chouhai12138/lite_Recording_Board/DOCS/开发步骤清单_v1.1.md

# 开发步骤清单 v1.1（底板未到 → 串口优先）

> 依据：`DOCS/STM32_软件框架与实施步骤.md`（框架，S0~S11）、
> `DOCS/STM32F407_电机驱动移植方案.md`（设计细节）、
> 参考实现：`/data/lite_motor_ws/src/lite_driver`。
> 本清单只改**执行顺序**，不改已冻结的设计决策。

---

## 0. 现状盘点

### 0.1 目标（文档已定）

独立板（不接 ROS）：双 CAN、4 键、ST7789 240×240、W25Q64、24C02、硬件急停；
功能 = MIT/CSP 控制、重力补偿拖动、动作录制/回放（5 槽）、16 轴归零。
裸机 + 1 ms 协作式调度，坐标空间全部用电机 raw。

### 0.2 可直接复用的资产（来自 lite_driver）

| 资产 | 路径 | 用法 |
|---|---|---|
| 帧编解码 / 量程 / 参数 ID | `include/lite_driver/protocol.hpp` | 逐行翻成 C（`rs_protocol.c/h`） |
| 协议测试向量 | `test/test_protocol.cpp`（409 行） | 改成主机侧 C 单测，逐字节比对 |
| 归零序列 | `src/tools/set_zero.cpp` | 照抄：失能→读 raw→类型 6→回读 |
| 拖动/激活斜坡 | `lite_controller/hold_controller` | 保留 Kp=0 / Kd / τ_ff 语义 |
| 重力模型 | `lite_controller/gravity_compensator` + `config/gravity/*` | 离线生成 C 表 + 手写 FK |
| 关节方向 | `lite_calibration/config/calibration.yaml` | 只取 `direction`（±1，重力用） |
| 电机静态参数 | `lite_controller/config/gravity/joint_spec.yaml` | 生成 `robot_config.c/h` |
| 惯量参数 | `lite_controller/config/gravity/inertia_params.yaml` | 生成重力表 |

### 0.3 当前硬件实况

| 资源 | 引脚 | 状态 |
|---|---|---|
| 调试串口 USART1 | PA9 / PA10 | ✅ 已通（WCH-Link CDC → `/dev/ttyACM0`） |
| SWD | PA13 / PA14 | ✅ 已通（WCH-Link） |
| 晶振 | HSE 25 MHz | ✅ 已确认（168 MHz） |
| LED RUN / CAN / FAULT | PA15 / PD15 / PD13 | ✅ 已驱动（PD12 已改为 LCD DC） |
| 按键 UP / DOWN | PA0（高有效）/ PD14（低有效） | ✅ 已驱动（底板左右键待定） |
| LCD 1.54" ST7789 240×240 | SPI2: PB13/PB15/PB14，DC=PD12，BL=PD11，无 CS/RST | 🟡 驱动已写（含 4 个方向/偏移），背光已亮，待确认画面 |
| LCD / W25Q64 / 24C02 / CAN 收发器 / 蜂鸣器 / 急停 | — | ❌ 底板未到，引脚未知 |

### 0.4 必须先解决的差异（**重要**）

1. **引脚冲突**：文档 v0 把 PB13/14/15 分给了 W25Q64 的 SPI2（SCK/MISO/MOSI），
   按键在 PE0~PE3。实际板子 PB13/14/15 + PD11 是**按键**，PE0~PE3 是否还在未知。
   → 底板到货后按新原理图重定外设引脚，`board_config.h` 是唯一改动点。
2. **按键语义**：文档假设 4 键 = 上/下/OK/BACK（**无左右**，纵向列表）；
   实际是 上/下/左/右。建议映射：**左 = 返回(BACK)，右 = 确认(OK)**，
   这样既保留文档的“纵向列表”交互，又不浪费左右键（可做页内快切）。
3. **4 个 LED 定位**：PA15 / PD15 / PD12 / PD13。建议语义：
   `PA15=RUN(心跳)`、`PD15=CAN/总线状态`、`PD12=REC(录制中)`、`PD13=FAULT`。

---

## 1. 目录结构（落地版，对齐文档 3.7）

```
stm32_lite_Recording_Board/
├── Core/            # 已有：时钟/中断/printf 重定向/链接脚本
├── BSP/             # 已有：led/uart；待加 keys、buzzer、power
├── App/
│   ├── app_sched.c/h        # 1 ms 协作调度（时间片表）
│   ├── app_state.c/h        # 模式状态机
│   ├── cfg/                 # robot_config.c/h、gravity_model_*.c/h（脚本生成）
│   ├── motor/               # rs_protocol、can_bus、motor_mgr、joint_map
│   ├── control/             # mit_ctrl、csp_ctrl、gravity、safety
│   ├── motion/              # recorder、playback、traj_store
│   └── ui/                  # ui_core（页面/导航）+ ui_text（串口后端）
├── Sim/                     # ★ 新增：虚拟 CAN 总线 + 16 台假电机
├── Scripts/                 # gen_robot_config.py、gen_gravity_model.py
├── Tests/                   # 主机侧 gcc 单测：test_protocol.c、test_gravity.c
└── DOCS/
```

关键设计：**UI 与存储都做成后端可替换**
（`ui_backend`：text→串口 / lvgl→ST7789；`traj_store`：RAM / W25Q64），
这样底板没到也能把 90% 的固件写完、测完。

---

## 2. 阶段 A：现在就能做（不依赖底板）

| # | 步骤 | 产出 | 验收 | 估时 |
|---|---|---|---|---|
| **A0** ✅ | 按键 + 4 LED 驱动 | `BSP/bsp_keys.c/h`（20 ms 消抖、1 s 长按、事件队列、可注入）、`bsp_led` 4 路、`board_config.h` 引脚 | ✅ 已上板验证：`key up`/`key right long` 事件正确、`keys` 读 0、`led rec/fault` 可控、PUPDR 确认上拉、MODER 确认输入/输出 | 0.5 d |
| **A1** ✅ | 串口文本 UI | `App/ui/ui_core.c`（页面树、4 键导航、设置项编辑）+ `ui_text.c`（文本后端，可换 LVGL）+ `ui_backend.h`（后端接口） | ✅ 已上板：主界面/MIT/CSP/录制/归零/设置/信息/安全 全部可进出；设置项可编辑保存；`ui <page>` 可跳页 | 1 d |
| **A2** ✅ | 协议层 C 版 | `App/motor/rs_protocol.c/h`（CommType、rs-00~06 量程/kt/额定峰值、参数 ID、MIT 编码、type2/24 解码、读参数、保存帧、CSP √2 折算、故障位描述） | ✅ `make test`：177 断言 0 失败（对应 `test_protocol.cpp` 全部用例 + MIT 帧布局） | 2 d |
| **A3** ✅ | 虚拟总线 | `Sim/sim_can.c` + `App/motor/can_bus.c`：16 台假电机（使能状态机、type2 回包、类型 6 写零、参数读、掉线/故障注入） | ✅ 实测：scan 16 台在线；move 跟踪；注入故障 → 自动失能；掉线 → 200ms 判离线 | 1 d |
| **A4** 🟡 | 电机管理（含双 CAN 移植） | `App/motor/motor_mgr.c/h`（Scan/Enable/Zero/Hold/MoveTo/超时/故障失能）+ 串口命令 | 🟡 16 台使能/失能/写零/HOLD/状态已通；**双 CAN 已移植**（CAN1=PB8/9，CAN2=PB12/6，1Mbit/s，回环自测 OK）；direction/homing_offset 已固化到 `App/cfg/joint_map.h`；MIT 力矩/速度已按 CAN ID 取型号量程（rs-02/rs-00/rs-05，`rs_limits_for_can_id()`）；待补 100Hz 抖动统计、真实总线上机 | 2 d |
| **A5** ✅ | MIT 控制 + 安全 | `App/control/mit_ctrl.c`（ZERO/HOLD/DRAG、500ms Kp 斜坡、DRAG 逐轴 kd 按 arms_grippers 表、±12N·m 钳位、NaN 回退）、电机超时 200ms 失能 | ✅ 实测 100.0 Hz（200 拍/2s），抖动窗口 min/max/avg = 10/10/10.00 ms，over=0 | 2 d |
| **A6** | 录制 / 回放（RAM 版） | `App/motion/recorder.c`、`playback.c`、`traj_store.c`（RAM 后端）；±15° 门禁 | sim 上录 60 s、回放跟踪误差 < 0.02 rad；门禁超差拒绝并指出轴号 | 3 d |
| **A7** | 归零 | `App/motion`/`cfg` 侧类型 6 序列 + pending + 回读 | sim 上 16 台写零后 \|raw\| < 2°；部分失败进维护态只允许重试 | 1 d |
| **A8** | CSP + MIT↔CSP 切换 | `App/control/csp_ctrl.c`（limit_spd/acc/limit_cur、首帧 loc_ref=当前 raw） | 切换无跳变；sim 上 loc_ref 跟踪误差 < 0.02 rad | 2 d |
| **A9** 🟡 | 配置/重力生成 | `Scripts/gen_gravity_model.py` + `Scripts/gen_joint_map.py` → `App/cfg/gravity_model.h` + `App/cfg/joint_map.h` + `App/control/gravity.c`；`gen_robot_config.py` 待做 | ✅ **重力已完成**（direction + homing_offset + 多圈 raw↔q）：与 pinocchio 200 组 max_err **7.0e-5 N·m**（< 1e-3）；配置生成待做 | 3 d |

阶段 A 完成后的状态：**不接底板、不接电机，整套逻辑（协议/CAN 管理/MIT/CSP/录制/回放/归零/重力/UI）都能在串口 + 虚拟总线上跑通并回归。**

---

## 3. 阶段 B：底板到货后（上板）

| # | 步骤 | 关键点 | 验收 |
|---|---|---|---|
| **B0** | 原理图核对、引脚定稿 | 解决 PB13/14/15 与 W25Q64 冲突；确认 CAN1/CAN2、LCD、EEPROM、蜂鸣器、急停、PD12/PD13 | `board_config.h` 与新原理图一致，编译通过 |
| **B1** | CAN 实机 | 双总线 1 Mbps、终端电阻、先单总线单电机再扩到 16 台 | 16 台全部在线，raw 与 ROS `set_zero --check` 一致（±0.01 rad） |
| **B2** | W25Q64 / 24C02 | `traj_store` 换 flash 后端（扇区双缓冲 + CRC + 完成标志）、设置持久化 | 5 槽各 ≥ 60 s，断电后完整；设置掉电保持 |
| **B3** | ST7789 + LVGL | `ui_backend` 换 LVGL 实现；字库子集放 W25Q64；只刷脏区 | 全流程不接串口可完成：上电→拖动→录制→回放→归零 |
| **B4** | 急停 / 电源 / 蜂鸣器 | 硬件断电 + 软件锁存；恢复后重新探测/使能 | 急停立即断电、屏幕锁存；恢复后正常 |
| **B5** | 实机联调 | MIT/CSP/重力拖动/录制/回放/归零 | 100 Hz 连续 30 min 抖动 < 2 ms；回放误差 < 0.02 rad |
| **B6** | 长稳与文档 | 故障注入（拔线/过温/总线错误）、100 次录制回放 | 连续 1 h 无 CAN 错误、无丢帧 |

---

## 4. 已确认（v1.1 落地）

- 按键语义：**LEFT = 返回、RIGHT = 确认**（UP/DOWN 选择）
- LED 极性：4 路均为**低电平点亮**；`PA15=RUN / PD15=CAN / PD12=REC / PD13=FAULT`
- 16 轴参数来源：`lite_controller/config/gravity/joint_spec.yaml` + `lite_calibration/config/calibration.yaml`

## 5. 原待确认项（已关闭）

1. **4 键语义**：左 = 返回、右 = 确认，行不行？（文档原本是 上/下/OK/BACK）
2. **PD12 / PD13**：极性是否和 PA15/PD15 一样（低电平点亮）？用途按 `REC/FAULT` 分配可以吗？
3. **底板会带哪些外设**：LCD、W25Q64、24C02、CAN 收发器、蜂鸣器、急停分别在底板还是主板上？
4. **16 轴配置最终版**：`joint_spec.yaml` + `calibration.yaml` 就是最终 can_id/型号/direction 吗？
   （`/data/lite_motor_ws/src/lite_controller/config/gravity/` 下的文件我都能直接拿来生成配置）

---

## 5. 建议的下一步（我现在就能动手）

**A0 + A2 并行**：A0 做完你就能用按键和串口操作板子；A2 完全是主机侧、不占硬件，
且它是后面所有控制逻辑的地基（文字 UI 也要显示协议解出来的 raw/温度/故障）。

*清单 v1.1，2025-11；与 DOCS 两份设计文档配套使用。*
