chouhai12138/lite_Recording_Board/Core/Inc/main.h

/**
 * @file    main.h
 * @brief   应用入口头文件
 */
#ifndef __MAIN_H__
#define __MAIN_H__

#ifdef __cplusplus
extern "C" {
#endif

#include "stm32f4xx_hal.h"
#include "board_config.h"

void Error_Handler(void);

#ifdef __cplusplus
}
#endif

#endif /* __MAIN_H__ */
