chouhai12138/lite_Recording_Board/Scripts/model/joint_spec.yaml

# 由 scripts/gen_joint_spec.py 从 ros2_control xacro 生成，请勿手工编辑。
# 重新生成：python3 scripts/gen_joint_spec.py
schema: 1
source:
  xacro: /data/lite_motor_ws/install/lite_description/share/lite_description/urdf/lite.urdf.xacro
  sha256: a77854c3633361aaa40ca319af60360d89c78de952b2241d9464b51ef31d3866
  generated: 2026-10-13T03:10:06+00:00
  mode: arms_grippers
joints:
  left_shoulder_pitch:
    side: left
    can_id: 11
    model: rs-02
    direction: -1
    interface_type: joint_position
    lower_limit: -3.141592653589793
    upper_limit: 0.7853981633974483
    torque_limit: 17.0
    max_safe_torque: 7.0
    limit_spd: 2.0
    acc_rad: 10.0
    current_limit: 27.0
    is_gripper: false
  left_shoulder_roll:
    side: left
    can_id: 12
    model: rs-00
    direction: -1
    interface_type: joint_position
    lower_limit: -1.5707963267948966
    upper_limit: 1.9198621771937625
    torque_limit: 14.0
    max_safe_torque: 7.0
    limit_spd: 2.0
    acc_rad: 10.0
    current_limit: 16.0
    is_gripper: false
  left_shoulder_yaw:
    side: left
    can_id: 13
    model: rs-00
    direction: 1
    interface_type: joint_position
    lower_limit: -1.5707963267948966
    upper_limit: 1.5707963267948966
    torque_limit: 14.0
    max_safe_torque: 2.5
    limit_spd: 2.0
    acc_rad: 10.0
    current_limit: 16.0
    is_gripper: false
  left_elbow_pitch:
    side: left
    can_id: 14
    model: rs-00
    direction: -1
    interface_type: joint_position
    lower_limit: -2.356194490192345
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
  right_gripper:
    side: right
    can_id: 28
    model: rs-05
    direction: -1
    interface_type: gripper_opening
    lower_limit: 0.0
    upper_limit: 0.047
    torque_limit: 4.0
    max_safe_torque: 0.25
    limit_spd: 2.0
    acc_rad: 10.0
    current_limit: 14.0
    is_gripper: true
