chouhai12138/lite_Recording_Board/App/ui/zh_font.h

/* 由 Scripts/gen_zh_font.py 自动生成，勿手改 */
#ifndef __ZH_FONT_H__
#define __ZH_FONT_H__

#include <stdint.h>

typedef struct {
    uint32_t code;      /* Unicode 码点 */
    uint8_t  w;         /* 字宽（8 或 16） */
    const uint8_t *rows;/* 16 行，每行 w/8 字节（MSB 在左） */
} zh_glyph_t;

static const uint8_t g_0020[16] = {
    0x00, 0x00, 0x00, 0x00, 0x00, 0x00, 0x00, 0x00, 0x00, 0x00, 0x00, 0x00, 0x00, 0x00, 0x00, 0x00
};
static const uint8_t g_0021[16] = {
    0x00, 0x00, 0x00, 0x10, 0x10, 0x10, 0x10, 0x10, 0x10, 0x00, 0x10, 0x10, 0x00, 0x00, 0x00, 0x00
};
static const uint8_t g_0022[16] = {
    0x00, 0x00, 0x00, 0x28, 0x28, 0x28, 0x00, 0x00, 0x00, 0x00, 0x00, 0x00, 0x00, 0x00, 0x00, 0x00
};
static const uint8_t g_0023[16] = {
    0x00, 0x00, 0x00, 0x00, 0x14, 0x14, 0x7E, 0x2C, 0x28, 0xFE, 0x48, 0x50, 0x00, 0x00, 0x00, 0x00
};
static const uint8_t g_0025[16] = {
    0x00, 0x00, 0x00, 0x60, 0x90, 0x90, 0x64, 0x18, 0x4C, 0x12, 0x12, 0x0C, 0x00, 0x00, 0x00, 0x00
};
static const uint8_t g_0026[16] = {
    0x00, 0x00, 0x00, 0x38, 0x60, 0x60, 0x20, 0x70, 0xDA, 0x8A, 0x44, 0x7E, 0x00, 0x00, 0x00, 0x00
};
static const uint8_t g_0027[16] = {
    0x00, 0x00, 0x00, 0x10, 0x10, 0x10, 0x00, 0x00, 0x00, 0x00, 0x00, 0x00, 0x00, 0x00, 0x00, 0x00
};
static const uint8_t g_0028[16] = {
    0x00, 0x00, 0x08, 0x18, 0x10, 0x10, 0x10, 0x30, 0x10, 0x10, 0x10, 0x18, 0x08, 0x00, 0x00, 0x00
};
static const uint8_t g_0029[16] = {
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
};
static const uint8_t g_FF1A[32] = {
    0x00, 0x00, 0x00, 0x00, 0x00, 0x00, 0x01, 0x80, 0x01, 0x80, 0x00, 0x00, 0x00, 0x00, 0x00, 0x00, 0x00, 0x00, 0x00, 0x00, 0x00, 0x00, 0x01, 0x80, 0x01, 0x80, 0x00, 0x00, 0x00, 0x00, 0x00, 0x00
};

static const zh_glyph_t kZhGlyphs[] = {
    {0x0020, 8, g_0020},
    {0x0021, 8, g_0021},
    {0x0022, 8, g_0022},
    {0x0023, 8, g_0023},
    {0x0025, 8, g_0025},
    {0x0026, 8, g_0026},
    {0x0027, 8, g_0027},
    {0x0028, 8, g_0028},
    {0x0029, 8, g_0029},
    {0x002A, 8, g_002A},
    {0x002B, 8, g_002B},
    {0x002C, 8, g_002C},
    {0x002D, 8, g_002D},
    {0x002E, 8, g_002E},
    {0x002F, 8, g_002F},
    {0x0030, 8, g_0030},
    {0x0031, 8, g_0031},
    {0x0032, 8, g_0032},
    {0x0033, 8, g_0033},
    {0x0034, 8, g_0034},
    {0x0035, 8, g_0035},
    {0x0036, 8, g_0036},
    {0x0037, 8, g_0037},
    {0x0038, 8, g_0038},
    {0x0039, 8, g_0039},
    {0x003A, 8, g_003A},
    {0x003B, 8, g_003B},
    {0x003C, 8, g_003C},
    {0x003D, 8, g_003D},
    {0x003E, 8, g_003E},
    {0x003F, 8, g_003F},
    {0x0040, 8, g_0040},
    {0x0041, 8, g_0041},
    {0x0042, 8, g_0042},
    {0x0043, 8, g_0043},
    {0x0044, 8, g_0044},
    {0x0045, 8, g_0045},
    {0x0046, 8, g_0046},
    {0x0047, 8, g_0047},
    {0x0048, 8, g_0048},
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
    {0x4ECD, 16, g_4ECD},
    {0x4EE5, 16, g_4EE5},
    {0x4F4D, 16, g_4F4D},
    {0x4F4E, 16, g_4F4E},
    {0x4F4F, 16, g_4F4F},
    {0x4F5C, 16, g_4F5C},
    {0x4F7F, 16, g_4F7F},
    {0x4FDD, 16, g_4FDD},
    {0x4FE1, 16, g_4FE1},
    {0x503C, 16, g_503C},
    {0x505C, 16, g_505C},
    {0x507F, 16, g_507F},
    {0x5148, 16, g_5148},
    {0x514D, 16, g_514D},
    {0x5168, 16, g_5168},
    {0x516C, 16, g_516C},
    {0x5171, 16, g_5171},
    {0x5175, 16, g_5175},
    {0x518D, 16, g_518D},
    {0x51FA, 16, g_51FA},
    {0x5217, 16, g_5217},
    {0x521D, 16, g_521D},
    {0x5230, 16, g_5230},
    {0x5236, 16, g_5236},
    {0x5237, 16, g_5237},
    {0x529B, 16, g_529B},
    {0x529F, 16, g_529F},
    {0x52A8, 16, g_52A8},
    {0x5316, 16, g_5316},
    {0x533A, 16, g_533A},
    {0x5355, 16, g_5355},
    {0x5360, 16, g_5360},
    {0x5382, 16, g_5382},
    {0x539F, 16, g_539F},
    {0x53C2, 16, g_53C2},
    {0x53D6, 16, g_53D6},
    {0x53D8, 16, g_53D8},
    {0x53E3, 16, g_53E3},
    {0x53EA, 16, g_53EA},
    {0x53EF, 16, g_53EF},
    {0x53F3, 16, g_53F3},
    {0x540E, 16, g_540E},
    {0x542F, 16, g_542F},
    {0x54E8, 16, g_54E8},
    {0x56DE, 16, g_56DE},
    {0x5728, 16, g_5728},
    {0x589E, 16, g_589E},
    {0x592A, 16, g_592A},
    {0x5931, 16, g_5931},
    {0x59CB, 16, g_59CB},
    {0x5B50, 16, g_5B50},
    {0x5B57, 16, g_5B57},
    {0x5B58, 16, g_5B58},
    {0x5B8C, 16, g_5B8C},
    {0x5B9A, 16, g_5B9A},
    {0x5B9E, 16, g_5B9E},
    {0x5BFC, 16, g_5BFC},
    {0x5C3C, 16, g_5C3C},
    {0x5C4F, 16, g_5C4F},
    {0x5DE6, 16, g_5DE6},
    {0x5DF2, 16, g_5DF2},
    {0x5E27, 16, g_5E27},
    {0x5E55, 16, g_5E55},
    {0x5E93, 16, g_5E93},
    {0x5E95, 16, g_5E95},
    {0x5F00, 16, g_5F00},
    {0x5F0F, 16, g_5F0F},
    {0x5F52, 16, g_5F52},
    {0x5F55, 16, g_5F55},
    {0x6001, 16, g_6001},
    {0x606F, 16, g_606F},
    {0x6210, 16, g_6210},
    {0x6267, 16, g_6267},
    {0x628A, 16, g_628A},
    {0x62D6, 16, g_62D6},
    {0x62E9, 16, g_62E9},
    {0x6301, 16, g_6301},
    {0x6309, 16, g_6309},
    {0x6362, 16, g_6362},
    {0x63A5, 16, g_63A5},
    {0x63D0, 16, g_63D0},
    {0x64E6, 16, g_64E6},
    {0x6539, 16, g_6539},
    {0x653E, 16, g_653E},
    {0x6548, 16, g_6548},
    {0x6570, 16, g_6570},
    {0x6574, 16, g_6574},
    {0x6587, 16, g_6587},
    {0x65B0, 16, g_65B0},
    {0x65B9, 16, g_65B9},
    {0x65E0, 16, g_65E0},
    {0x662F, 16, g_662F},
    {0x663E, 16, g_663E},
    {0x6709, 16, g_6709},
    {0x671F, 16, g_671F},
    {0x673A, 16, g_673A},
    {0x6761, 16, g_6761},
    {0x677F, 16, g_677F},
    {0x6848, 16, g_6848},
    {0x69FD, 16, g_69FD},
    {0x6A21, 16, g_6A21},
    {0x6B21, 16, g_6B21},
    {0x6B62, 16, g_6B62},
    {0x6D88, 16, g_6D88},
    {0x72B6, 16, g_72B6},
    {0x73B0, 16, g_73B0},
    {0x751F, 16, g_751F},
    {0x7535, 16, g_7535},
    {0x753B, 16, g_753B},
    {0x7559, 16, g_7559},
    {0x7684, 16, g_7684},
    {0x76D6, 16, g_76D6},
    {0x76EE, 16, g_76EE},
    {0x77E9, 16, g_77E9},
    {0x786E, 16, g_786E},
    {0x793A, 16, g_793A},
    {0x79D2, 16, g_79D2},
    {0x7A7A, 16, g_7A7A},
    {0x7ED9, 16, g_7ED9},
    {0x7F13, 16, g_7F13},
    {0x7F16, 16, g_7F16},
    {0x7F6E, 16, g_7F6E},
    {0x80FD, 16, g_80FD},
    {0x81EA, 16, g_81EA},
    {0x822A, 16, g_822A},
    {0x83DC, 16, g_83DC},
    {0x884C, 16, g_884C},
    {0x8865, 16, g_8865},
    {0x8868, 16, g_8868},
    {0x88AB, 16, g_88AB},
    {0x8981, 16, g_8981},
    {0x8986, 16, g_8986},
    {0x8BA4, 16, g_8BA4},
    {0x8BE5, 16, g_8BE5},
    {0x8C03, 16, g_8C03},
    {0x8D25, 16, g_8D25},
    {0x8F91, 16, g_8F91},
    {0x8FD0, 16, g_8FD0},
    {0x8FD4, 16, g_8FD4},
    {0x9009, 16, g_9009},
    {0x903B, 16, g_903B},
    {0x907F, 16, g_907F},
    {0x90E8, 16, g_90E8},
    {0x91CD, 16, g_91CD},
    {0x91CF, 16, g_91CF},
    {0x952E, 16, g_952E},
    {0x95F4, 16, g_95F4},
    {0x963B, 16, g_963B},
    {0x9650, 16, g_9650},
    {0x9664, 16, g_9664},
    {0x968F, 16, g_968F},
    {0x9694, 16, g_9694},
    {0x96C6, 16, g_96C6},
    {0x96F6, 16, g_96F6},
    {0x9700, 16, g_9700},
    {0x9762, 16, g_9762},
    {0x9875, 16, g_9875},
    {0x9879, 16, g_9879},
    {0x9A71, 16, g_9A71},
    {0xFF08, 16, g_FF08},
    {0xFF09, 16, g_FF09},
    {0xFF0C, 16, g_FF0C},
    {0xFF1A, 16, g_FF1A},
};
#define ZH_GLYPH_COUNT (sizeof(kZhGlyphs)/sizeof(kZhGlyphs[0]))

#endif
